joriswegner/beatingsignal/Anleitung.pdf

### Materialliste:

ATMEGA328P - Microchip IC-Sockel 28-Pin Stiftleiste Rastermaß 2.54mm 3x Potentiometer 10K linear 16MHz-Quartz 2x22pF-Scheibenkondensator 3x Taster 2x Elektrolytkondensator 220uF 78L05 Spannungswandler Diode Hohlsteckerbuchse 3x Widerstand 220 Ohm 3x Widerstand 10k Ohm 2x WIderstand 100k Ohm LED grün LED gelb oder nach Geschmack LM358 OPAMP oder ähnlich IC-Sockel 8-Pin Photowiderstand 3x Kondensator 100n Klinkenbuchse Krokokabel Evtl. Schrumpfschlauch

### Genaue Teileliste auf Reichelt.de: https://www.reichelt.de/my/1454947

### Da der Schaltkreis des Synthesizers auf dem Nebulophone von Bleep Labs basiert, kann auf die Anleitungen und Tipps unter

https://bleeplabs.com/store/nebulophone/ zurückgegrien werden.

Zum Betrieb ist ein 9V-Netzteil mit Hohlstecker (Pluspol innen) nötig. Das Ausgangssignal ist monophon.

Der Microcontroller muss natürlich noch programmiert werden.

### Der Arduino-Code ist unter github.com/joriswegner/beatingsignal verfügbar. Am einfachsen lässt er sich mit einem älteren Arduino Uno

mit gesockeltem Microcontroller aufspielen.
Ansonsten gibt es viele Tutorials im Netz.

### Ein gute Grundlage: https://www.arduino.cc/en/Tutorial/ArduinoToBreadboard

### Lötanleitung für Anfänger: https://www.youtube.com/watch?v=QKbJxytERvg

### Beating Signals Diskografie: https://beatingsignal.bandcamp.com/

# BEATING SIGNAL - THE STORY - ANLEITUNG

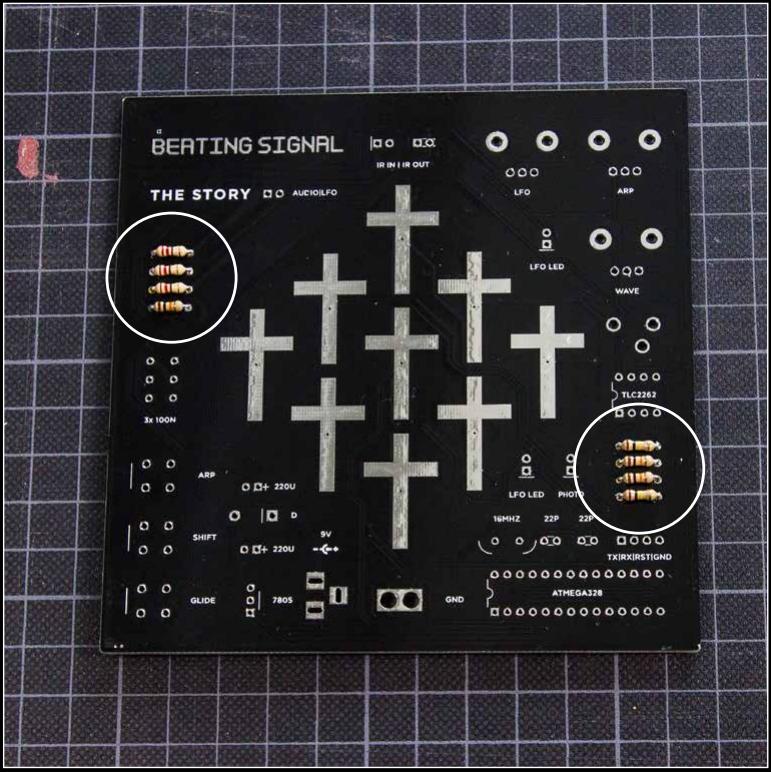
[picture p1: figure]

1 - Die Widerstände wie auf der Platine beschriftet einlöten.

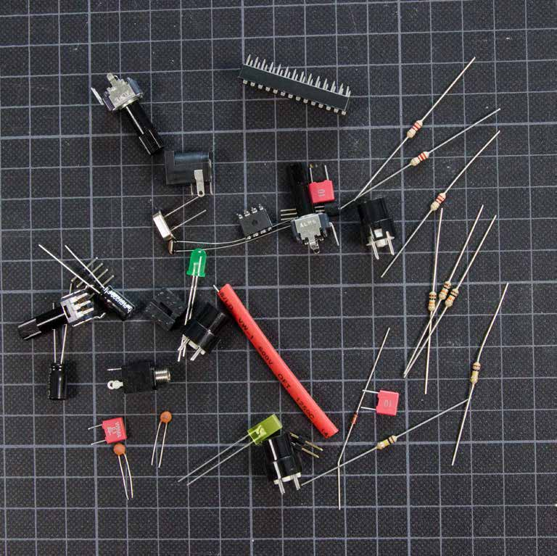
[picture p2: figure]
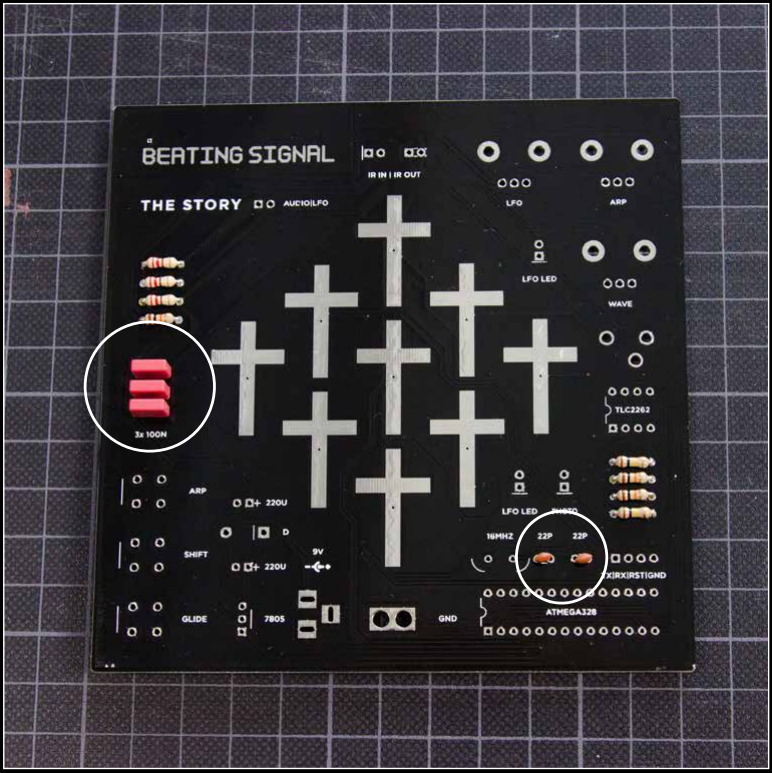
[picture p3: figure]
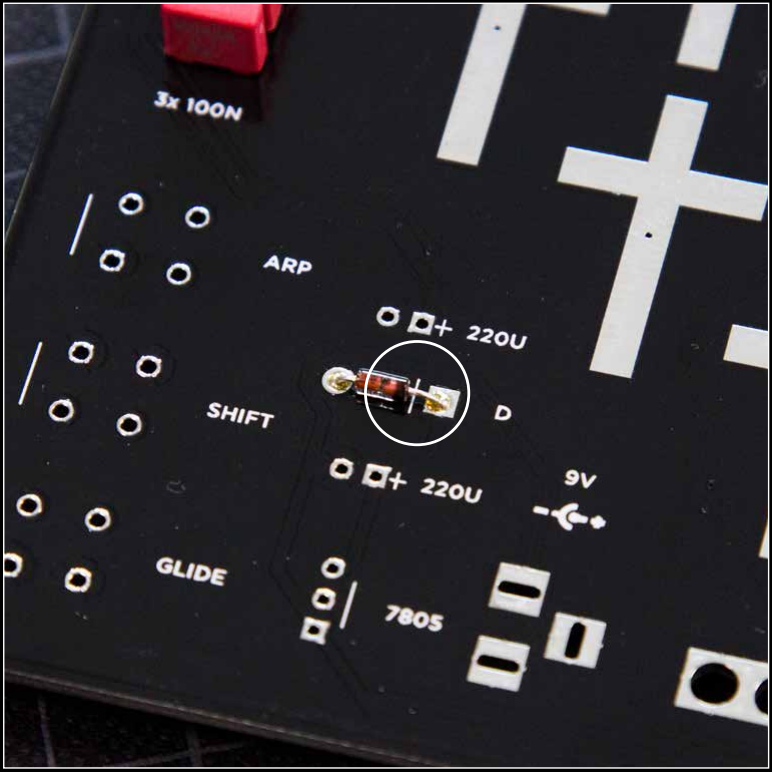
[picture p4: figure]

2 - 100nF- und 22pF-Kondensatoren hinzufügen. | 3 - Verpolungsschutz-Diode einlöten. Der schwarze Ring der Diode muss in Richtung des weißen Striches auf der Platine zeigen.

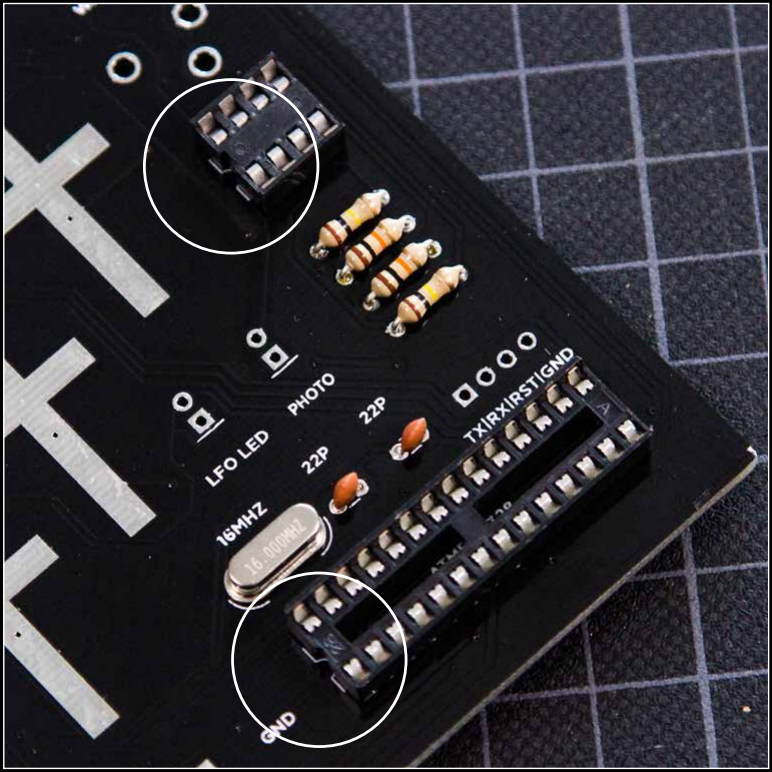
[picture p5: figure]

4 - Schwingquartz und Sockel werden eingelötet. Die kleinen Einkerbungen der Sockel zeigen nach links.

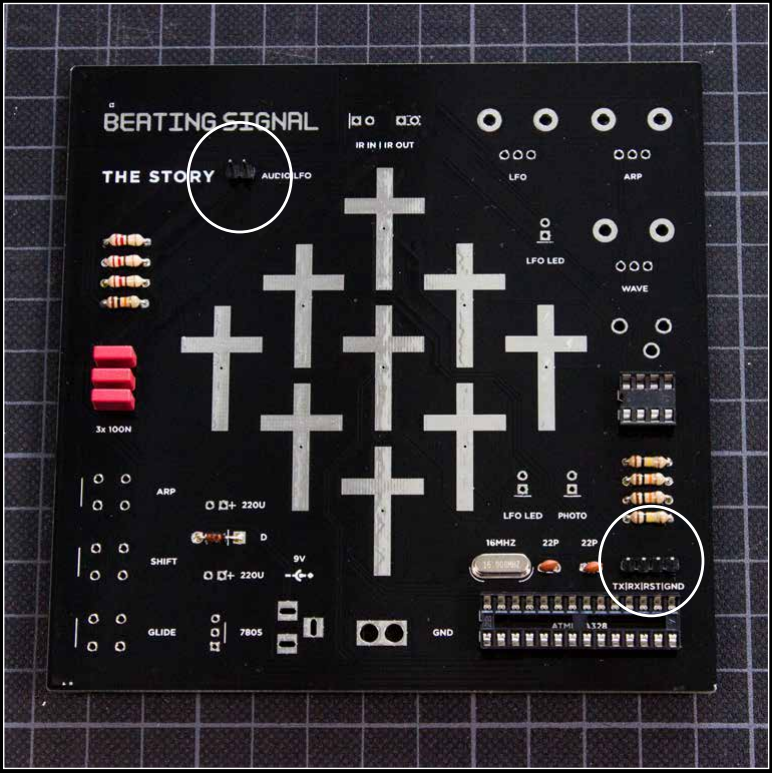
[picture p6: figure]

5 - Die Stiftleiste unten dient als Programmieradapter, die kurze Leiste oben, um LFO und unverstärktes Audiosignal für Experimente abzugreifen.

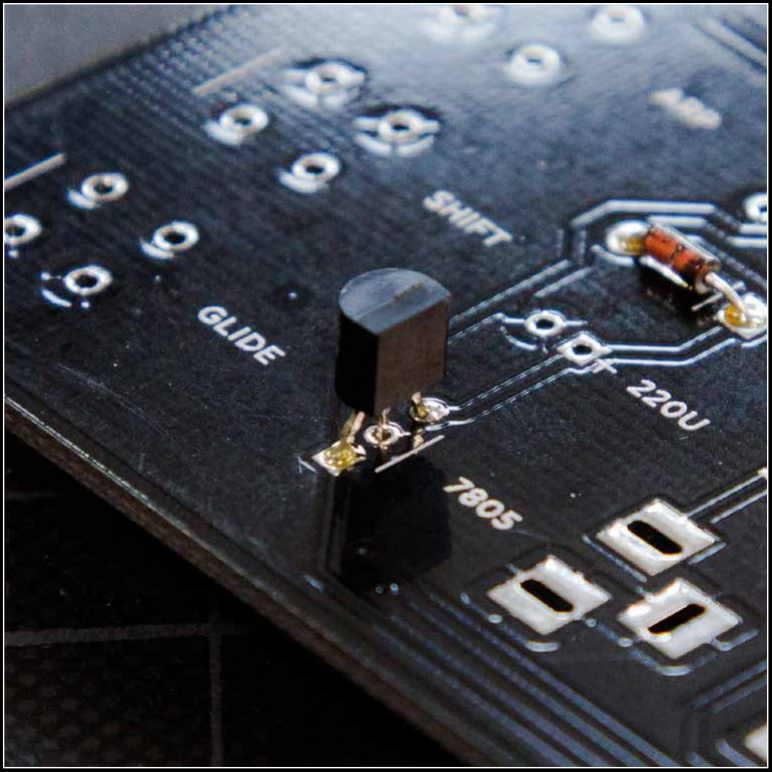
[picture p7: figure]
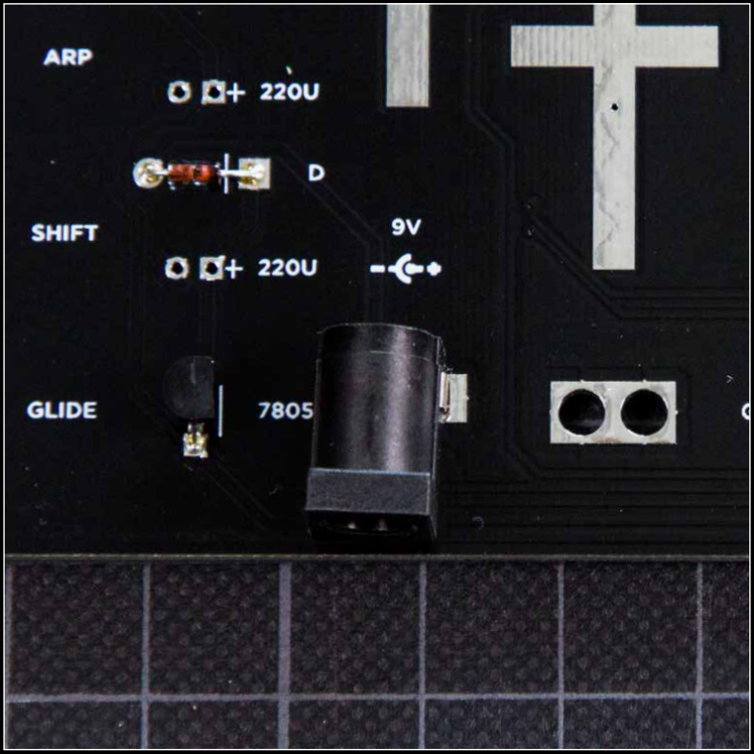
[picture p8: figure]

6 - Die flache Seite des Spannungsreglers liegt in Richtung des Striches. | 7 - Die Holsteckerbuchse nimmt herkömmliche 5mm-Hohlstecker auf. Bitte Netzteile mit 9V und dem Pluspol innen verwenden.

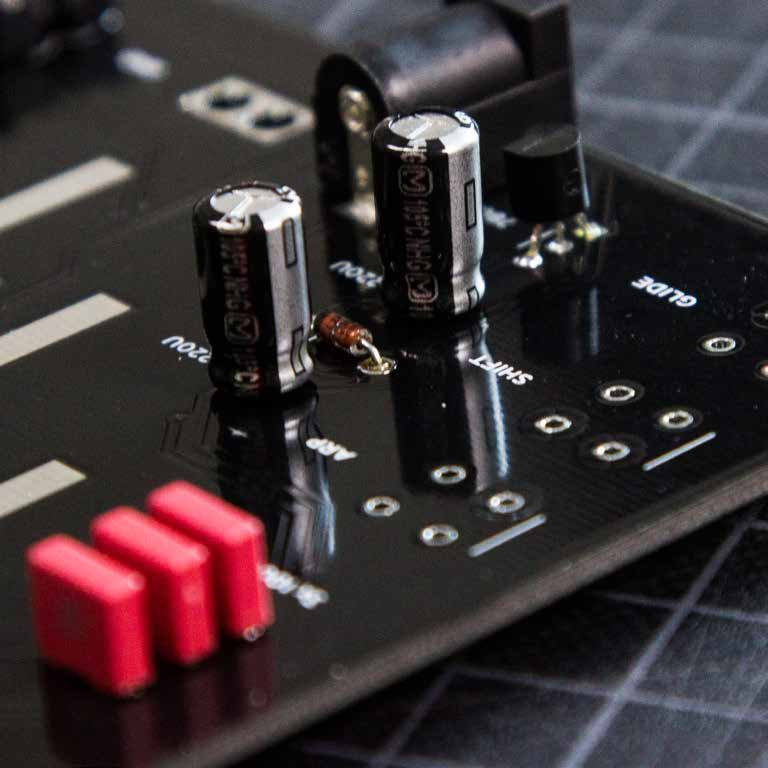
[picture p9: figure]
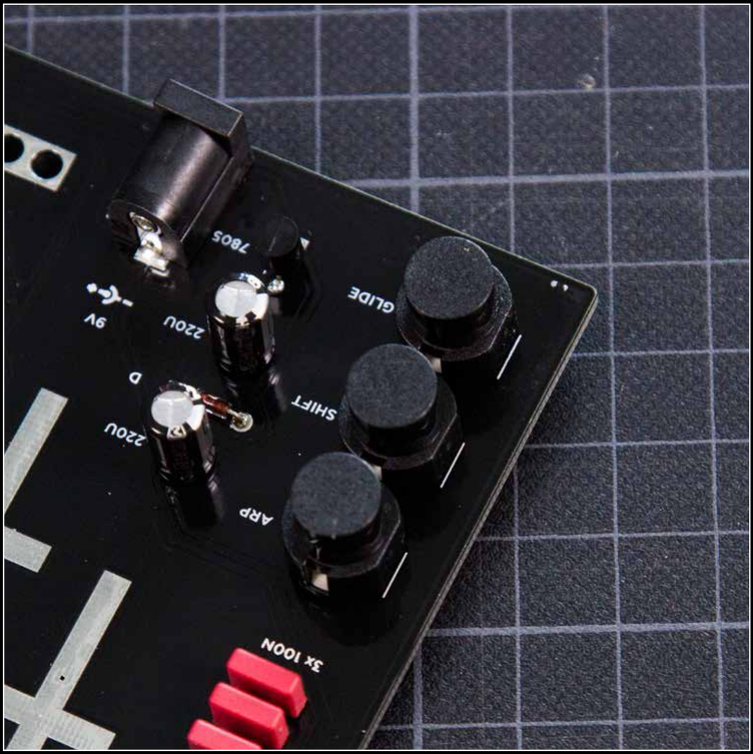
[picture p10: figure]

8 - Die Minus-Seite der Elektrolytkondensatoren muss zum Platinenrand weisen. | 9. Genau wie die flache Seite der Taster.

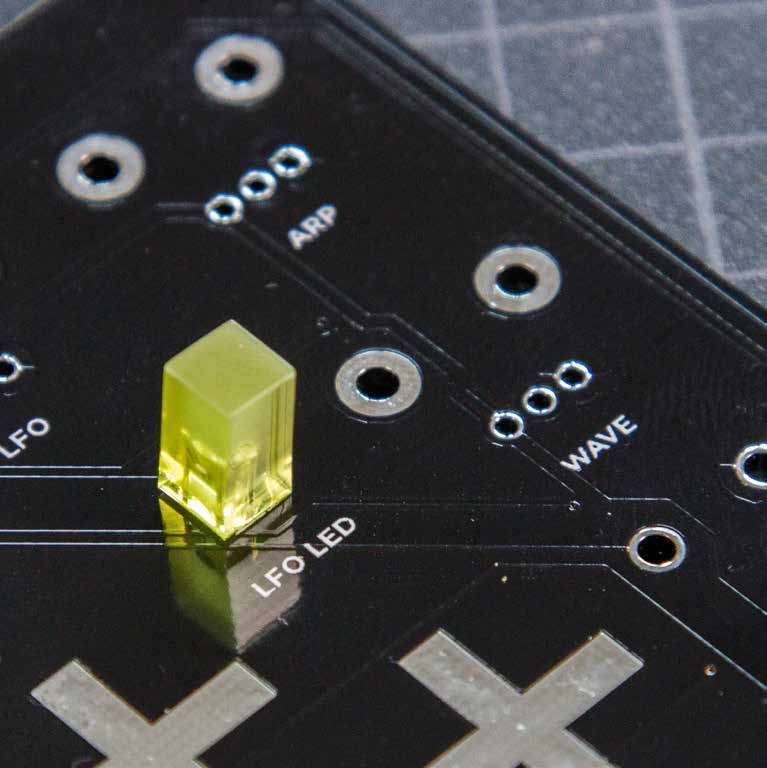
[picture p11: figure]
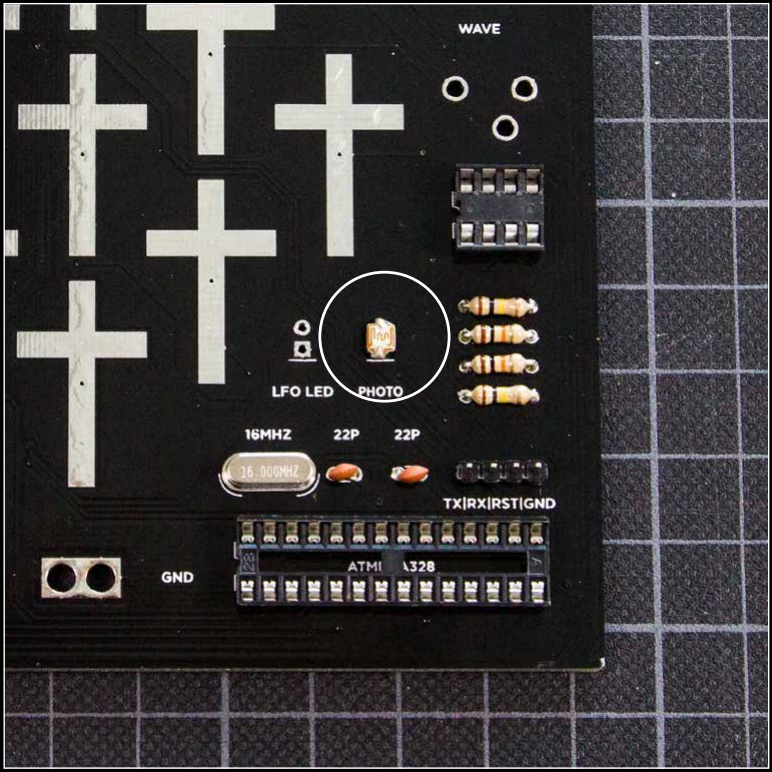
[picture p12: figure]

10 - Eine LED wird mit dem kürzeren Bein im eckigen Loch eingelötet. | 11 - Den lichtempfindlichen Widerstand hinzufügen.

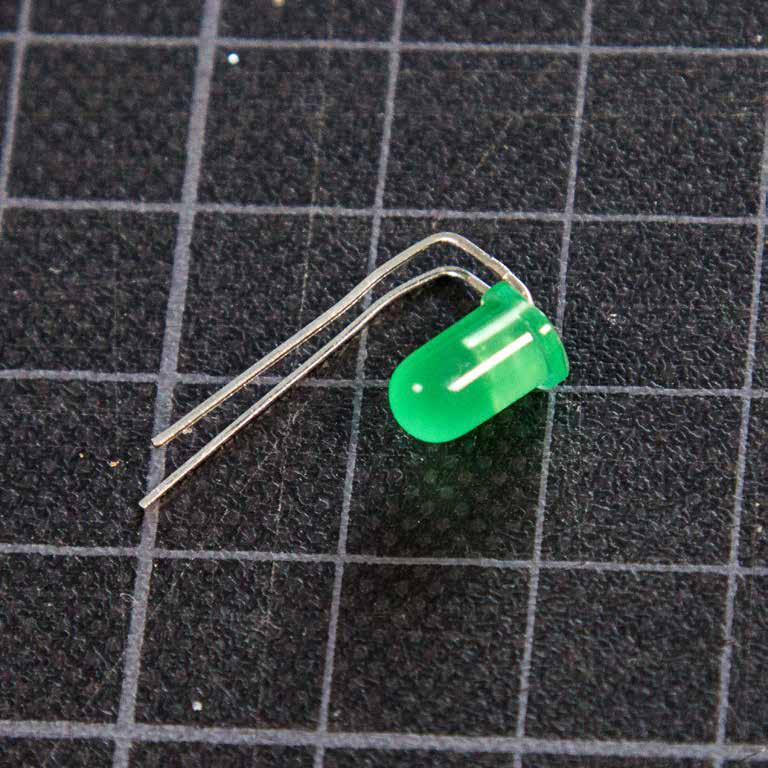
[picture p13: figure]
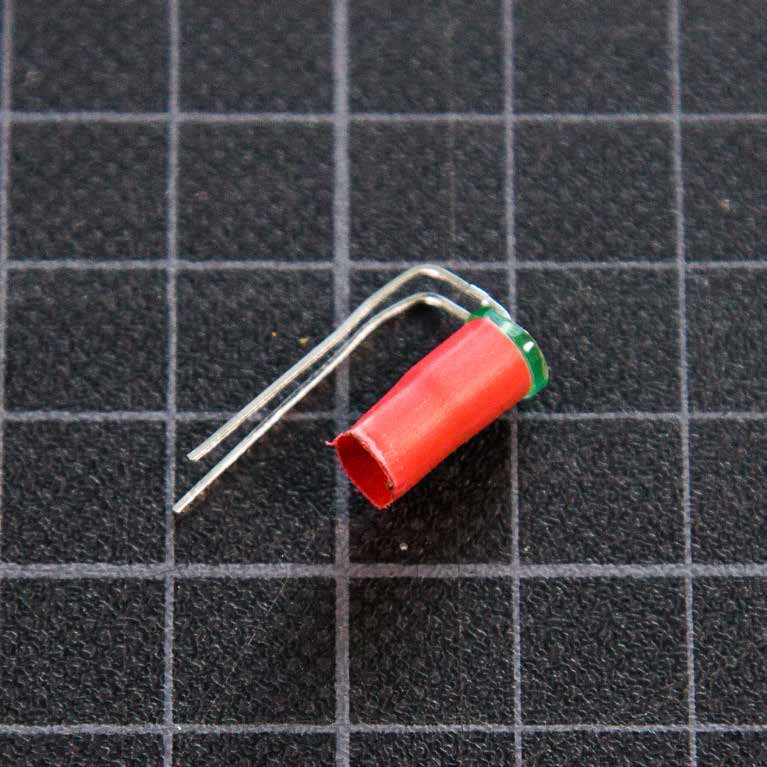
[picture p14: figure]

12 - Eine grüne LED wie gezeigt umbiegen... | 13 - ...und mit Schrumpfschlauch versehen. Noch nicht schrumpfen - bei gutem Halt ist gar kein Schrumpfen nötig. Es funktioniert auch ohne Schlauch gut.

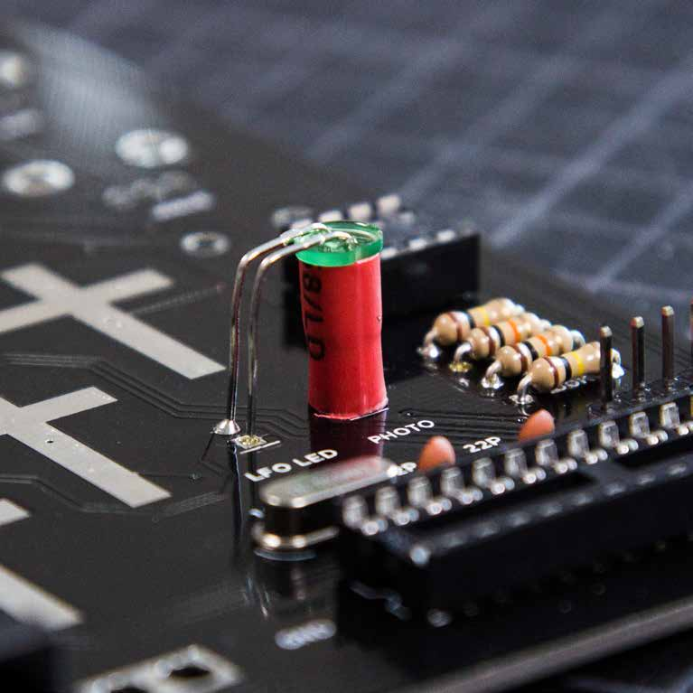
[picture p15: figure]

13 - Die LED so einlöten, dass der lichtempfindliche Widerstand von der LED

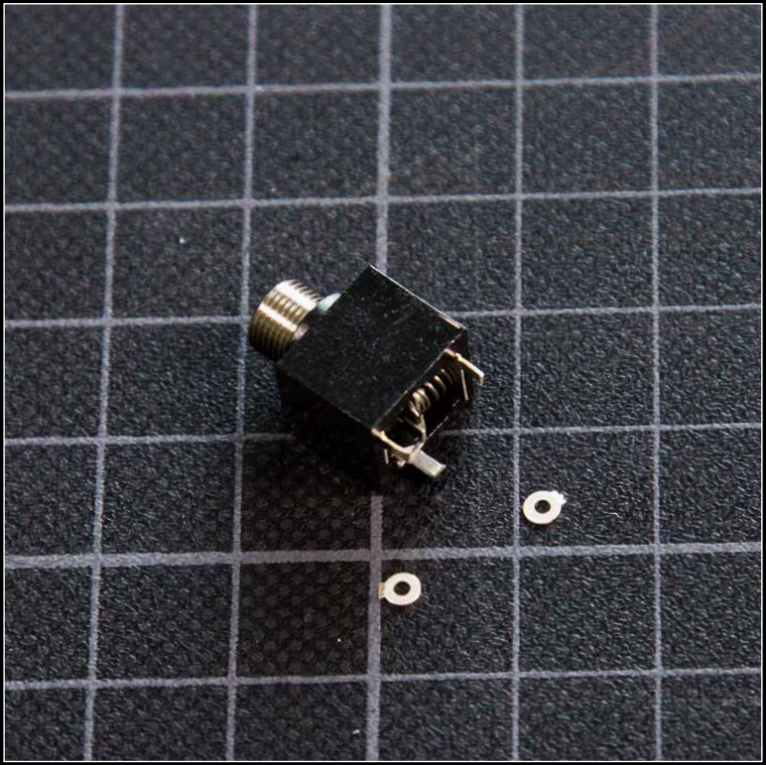
[picture p16: figure]

beleuchtet und vom Schrumpfschlauch ummantelt wird. | 14 - Die Lötösen der Buchse mit einem Seitenschneider abtrennen.

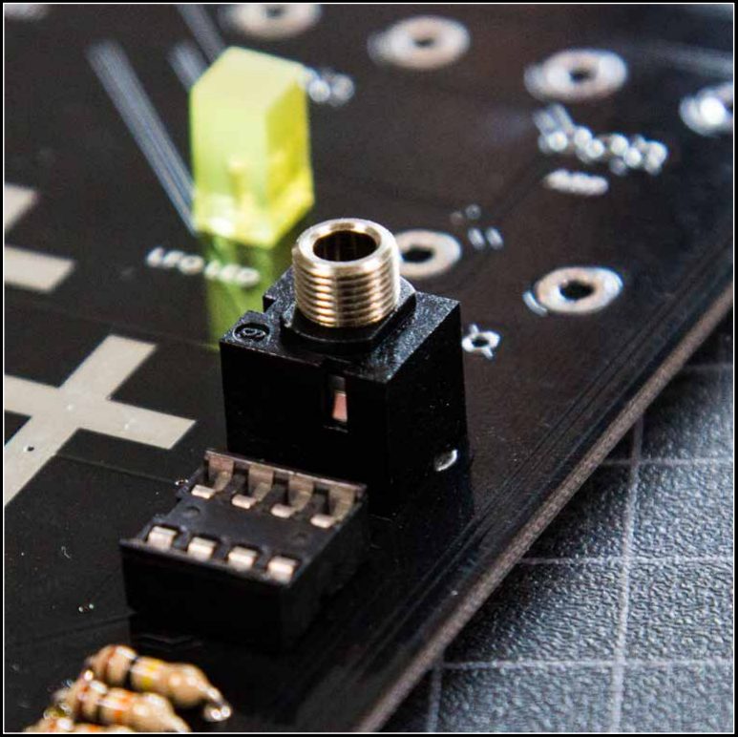
[picture p17: figure]
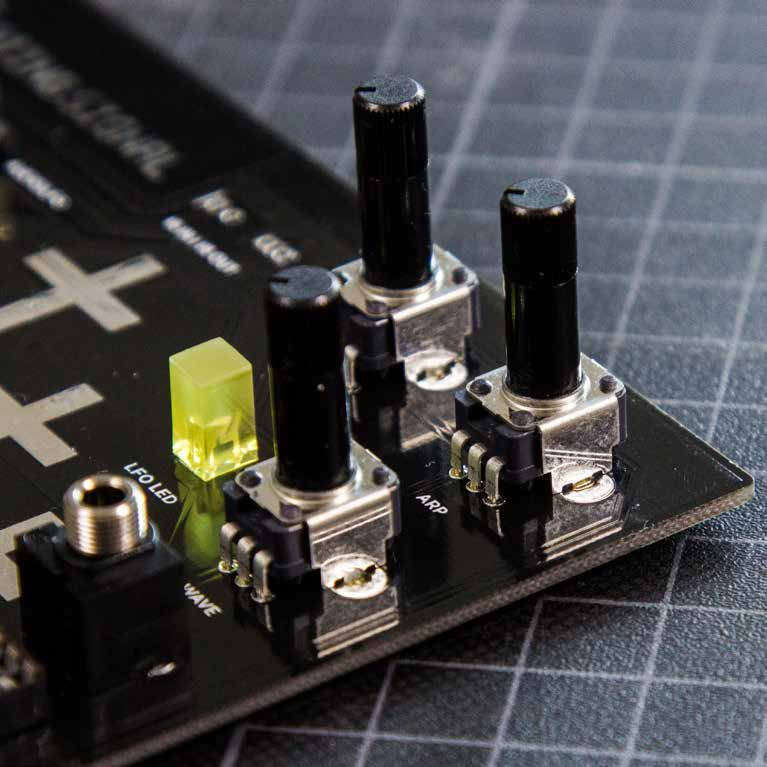
[picture p18: figure]

15 - Die Buchse einlöten. | 16 - Die Potentiometer einbauen.

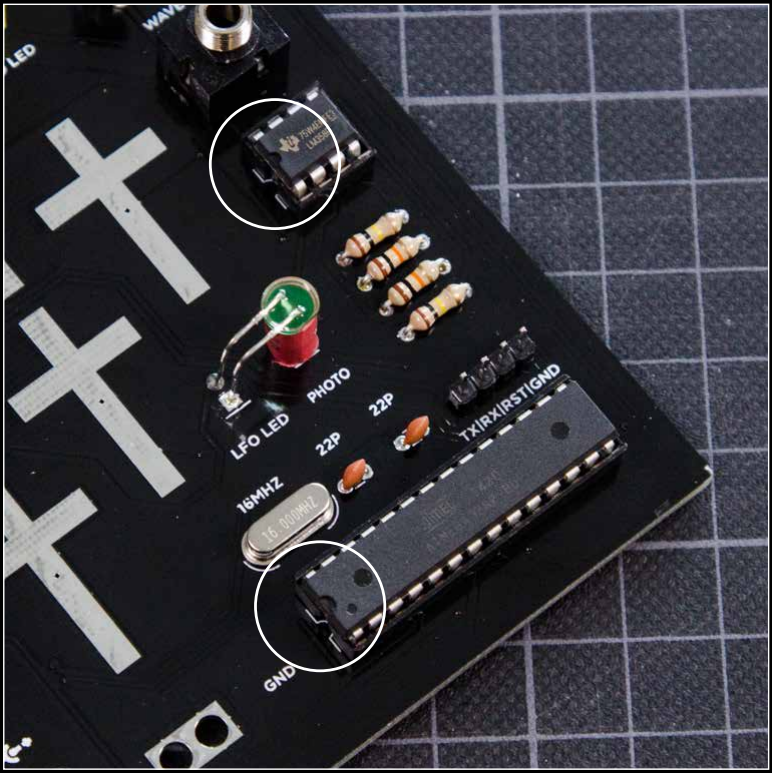
[picture p19: figure]

17 - Die integrierten Schaltkreise vorsichtig in die Sockel setzen - deren Einkerbungen müssen ebenfalls nach links deuten.

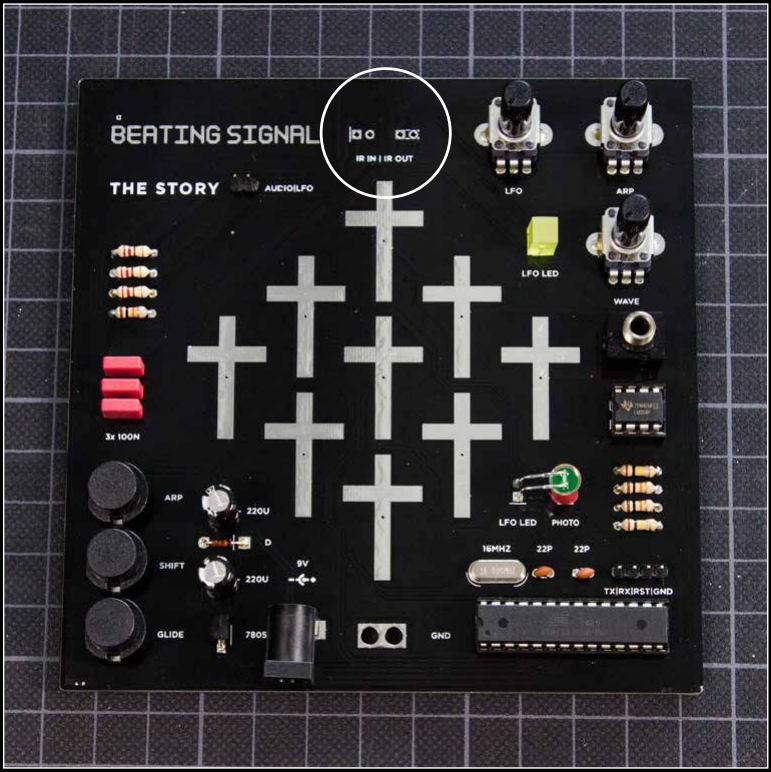
[picture p20: figure]

18 - Fertig! Oben können noch eine IR-Diode und ein Fototransistor für experimente eingesetzt werden, der Synthesizer funktioniert aber ohne sie.

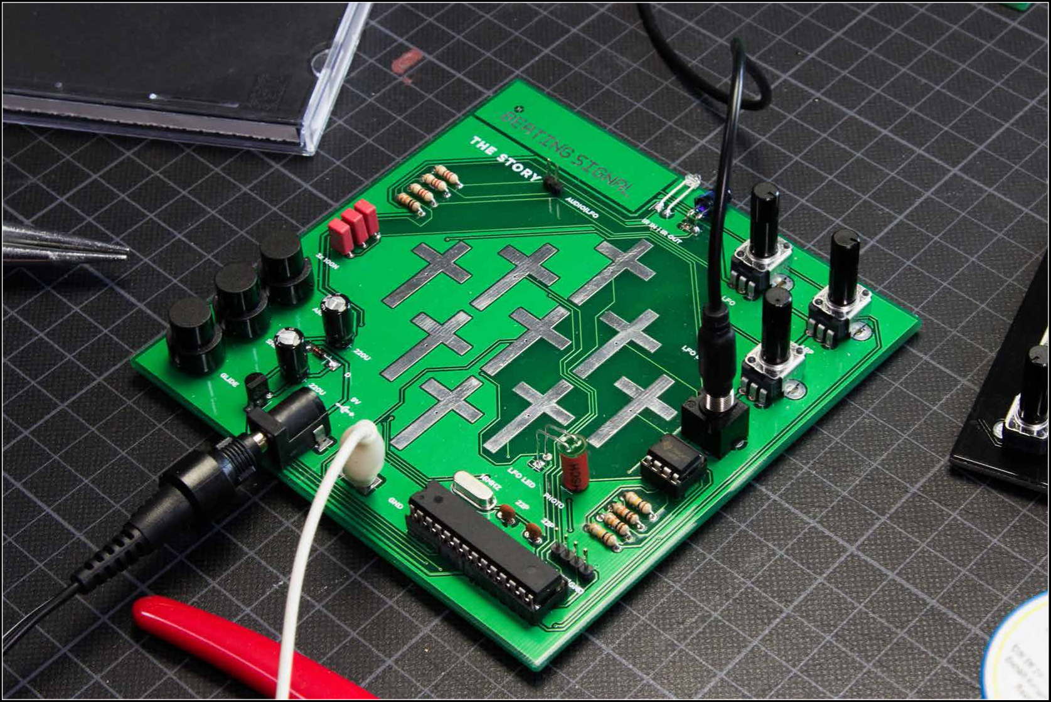
[picture p21: figure]

19 - Ein Krokodilkabel in das untere Feld klemmen und mit der anderen Seite auf den Kontaktfeldern spielen.
