joriswegner/beatingsignal/PCB Files/Beating Signal.kicad_pcb

## KiCad design PCB Files/Beating Signal.kicad_pcb (2018-04-08)

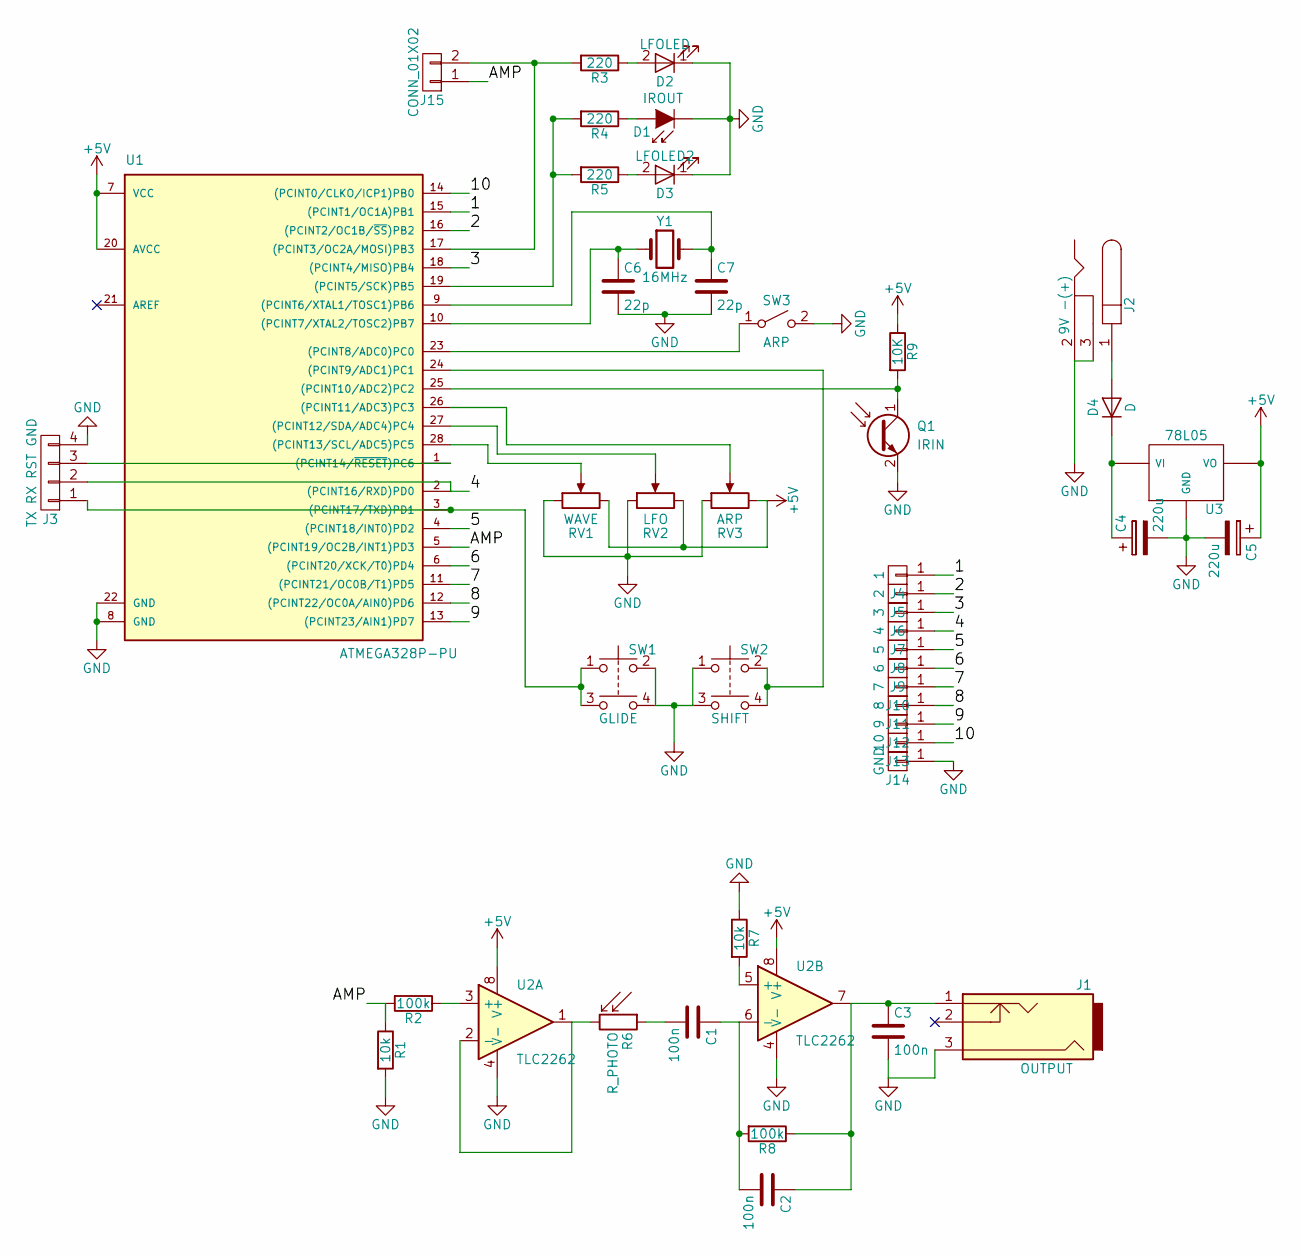
[picture p22: schematic Beating Signal.sch]

Parts:
C1, C2, C3: 100n; C_Rect_L7.0mm_W2.5mm_P5.00mm
C4, C5: 220u; CP_Radial_D5.0mm_P2.50mm
C6, C7: 22p; C_Disc_D3.0mm_W1.6mm_P2.50mm
D1: IROUT; LED_SideEmitter_Rectangular_W4.5mm_H1.6mm
D2: LFOLED; LED_D5.0mm
D3: LFOLED2; LED_D5.0mm
D4: D; D_DO-41_SOD81_P7.62mm_Horizontal
J1: OUTPUT; Buchse
J2: 9V -(+); BARREL_JACK
J3: TX RX RST GND; Pin_Header_Straight_1x04_Pitch2.54mm
J4: 1; Cross_Contact_A02
J5: 2; Cross_Contact_A02
J6: 3; Cross_Contact_A02
J7: 4; Cross_Contact_A02
J8: 5; Cross_Contact_A02
J9: 6; Cross_Contact_A02
J10: 7; Cross_Contact_A02
J11: 8; Cross_Contact_A02
J12: 9; Cross_Contact_A02
J13: 10; BeatingSignalNameA02
J14: GND; GND_Contact_A01
J15: CONN_01X02; Pin_Header_Straight_1x02_Pitch2.54mm
Q1: IRIN; LED_D5.0mm
R1, R7: 10k; R_Axial_DIN0207_L6.3mm_D2.5mm_P7.62mm_Horizontal
R2, R8: 100k; R_Axial_DIN0207_L6.3mm_D2.5mm_P7.62mm_Horizontal
R3, R4, R5: 220; R_Axial_DIN0207_L6.3mm_D2.5mm_P7.62mm_Horizontal
R6: R_PHOTO; LED_D5.0mm
R9: 10K; R_Axial_DIN0207_L6.3mm_D2.5mm_P7.62mm_Horizontal
RV1: WAVE; Potentiometer_Alps_RK09K_Vertical
RV2: LFO; Potentiometer_Alps_RK09K_Vertical
RV3: ARP; Potentiometer_Alps_RK09K_Vertical
SW1: GLIDE; Switch_DT6SW
SW2: SHIFT; Switch_DT6SW
SW3: ARP; Switch_DT6SW
U1: ATMEGA328P-PU; DIP-28_W7.62mm
U2: TLC2262; DIP-8_W7.62mm
U3: 78L05; 78L05_TO-92
Y1: 16MHz; Crystal_HC49-4H_Vertical

Connections:
+5V: C5.1, R9.1, RV1.3, RV2.3, RV3.3, U1.7 (VCC), U1.20 (AVCC), U2.8 (V+), U3.VO
/1: J4.1, U1.15 ((PCINT1/OC1A)PB1)
/2: J5.1, U1.16 ((PCINT2/OC1B/~SS~)PB2)
/3: J6.1, U1.18 ((PCINT4/MISO)PB4)
/4: J3.2, J7.1, U1.2 ((PCINT16/RXD)PD0)
/5: J8.1, U1.4 ((PCINT18/INT0)PD2)
/6: J9.1, U1.6 ((PCINT20/XCK/T0)PD4)
/7: J10.1, U1.11 ((PCINT21/OC0B/T1)PD5)
/8: J11.1, U1.12 ((PCINT22/OC0A/AIN0)PD6)
/9: J12.1, U1.13 ((PCINT23/AIN1)PD7)
/10: J13.1, U1.14 ((PCINT0/CLKO/ICP1)PB0)
/AMP: J15.1, R1.1, R2.2, U1.5 ((PCINT19/OC2B/INT1)PD3)
GND: C3.2, C4.2, C5.2, C6.2, C7.2, D1.1 (K), D2.1 (K), D3.1 (K), J1.3, J2.2, J2.3, J3.4, J14.1, Q1.2 (E), R1.2, R7.1, RV1.1, RV2.1, RV3.1, SW1.2, SW1.4, SW2.1, SW2.3, SW3.2 (B), U1.8 (GND), U1.22 (GND), U2.4 (V-), U3.GND
unnamed: C1.1, C2.2, R8.2, U2.6 (-)
unnamed: C1.2, R6.1
unnamed: C2.1, C3.1, J1.1, R8.1, U2.7
unnamed: C4.1, D4.1 (K), U3.VI
unnamed: C6.1, U1.10 ((PCINT7/XTAL2/TOSC2)PB7), Y1.1
unnamed: C7.1, U1.9 ((PCINT6/XTAL1/TOSC1)PB6), Y1.2
unnamed: D1.2 (A), R4.1
unnamed: D2.2 (A), R3.1
unnamed: D3.2 (A), R5.1
unnamed: D4.2 (A), J2.1
unnamed: J3.1, SW1.1, SW1.3, U1.3 ((PCINT17/TXD)PD1)
unnamed: J3.3, U1.1 ((PCINT14/~RESET~)PC6)
unnamed: J15.2, R3.2, U1.17 ((PCINT3/OC2A/MOSI)PB3)
unnamed: Q1.1 (C), R9.2, U1.25 ((PCINT10/ADC2)PC2)
unnamed: R2.1, U2.3 (+)
unnamed: R4.2, R5.2, U1.19 ((PCINT5/SCK)PB5)
unnamed: R6.2, U2.1, U2.2 (-)
unnamed: R7.2, U2.5 (+)
unnamed: RV1.2, U1.28 ((PCINT13/SCL/ADC5)PC5)
unnamed: RV2.2, U1.27 ((PCINT12/SDA/ADC4)PC4)
unnamed: RV3.2, U1.26 ((PCINT11/ADC3)PC3)
unnamed: SW2.2, SW2.4, U1.24 ((PCINT9/ADC1)PC1)
unnamed: SW3.1 (A), U1.23 ((PCINT8/ADC0)PC0)

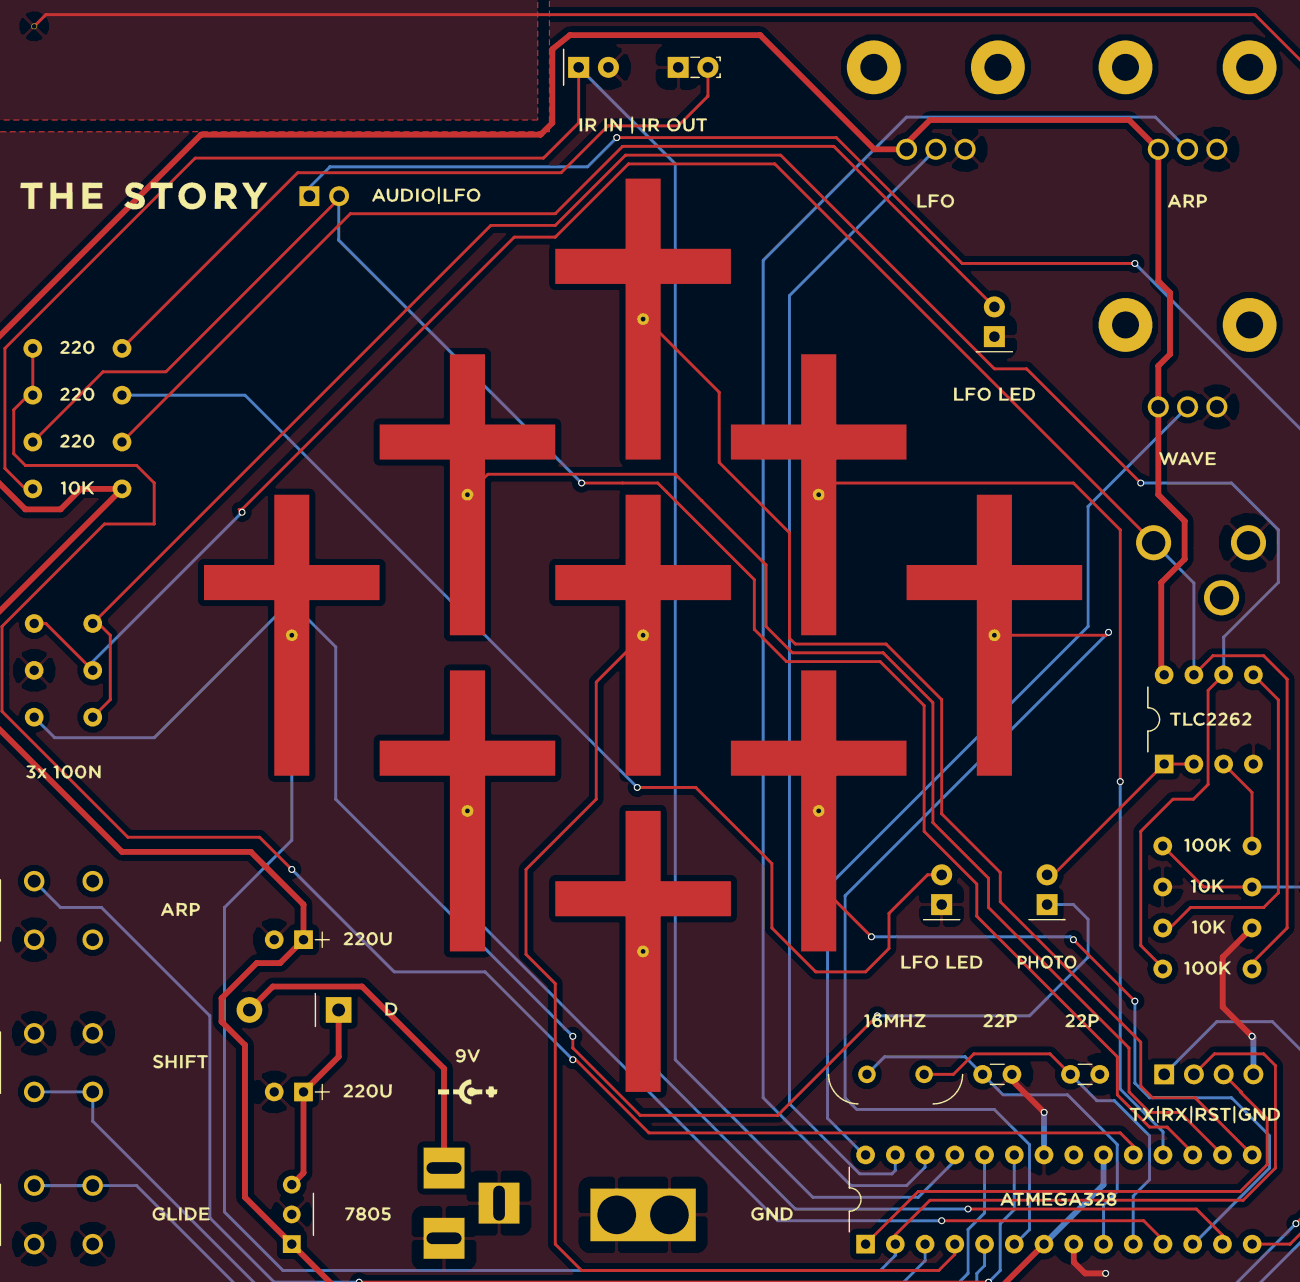
[picture p23: board Beating Signal.kicad_pcb from above]

Board: 2 copper layers, 46 parts (0 on the bottom side), 36 nets.
